asalahialassbahi-png/Rooftop/renders/step_7.png

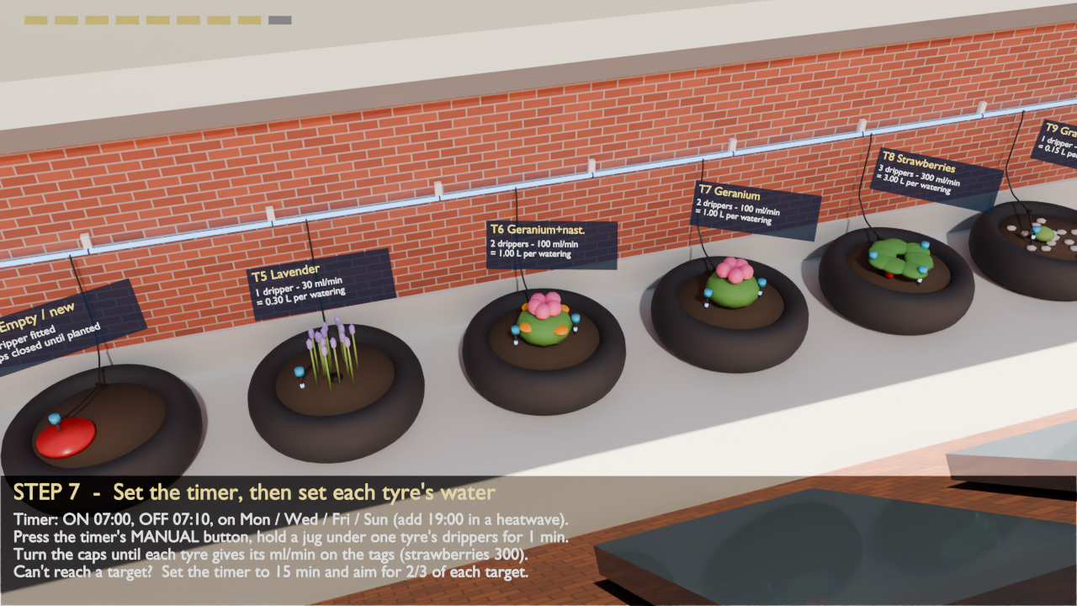
renders/step_7.png
