asalahialassbahi-png/Rooftop/renders/step_5.png

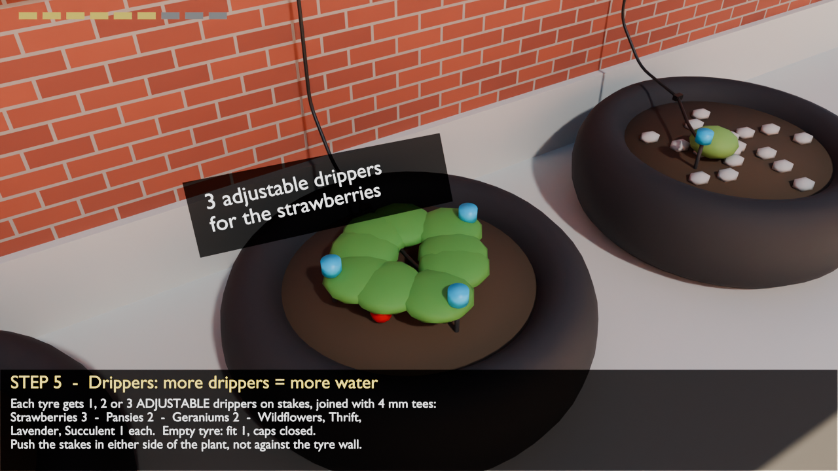
renders/step_5.png
