asalahialassbahi-png/Rooftop/(list of files, cad)

Other CAD files:
blender/irrigation_guide.blend
