asalahialassbahi-png/Rooftop/renders/step_0.png

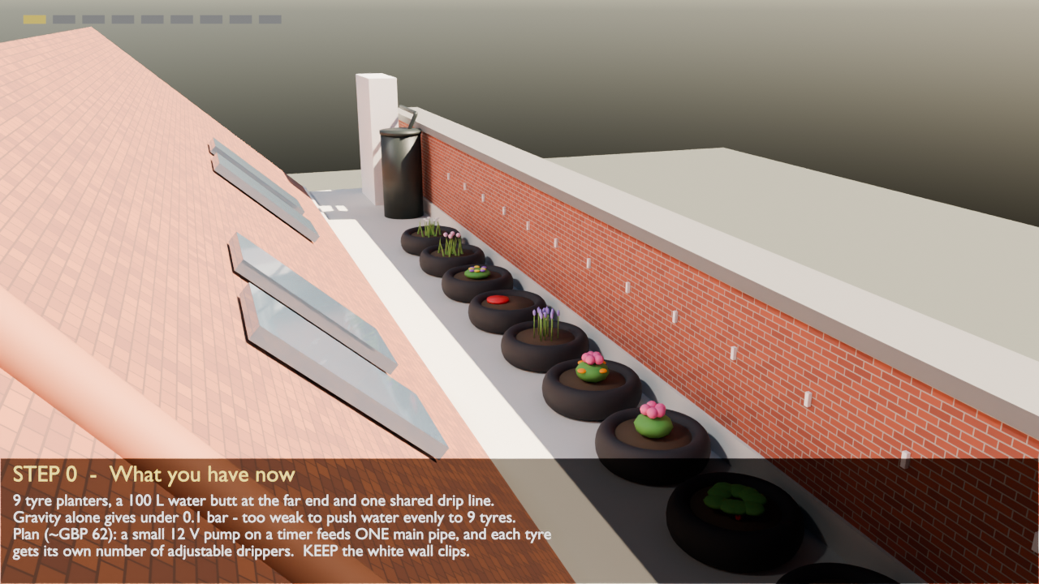
renders/step_0.png
