asalahialassbahi-png/Rooftop/renders/step_1.png

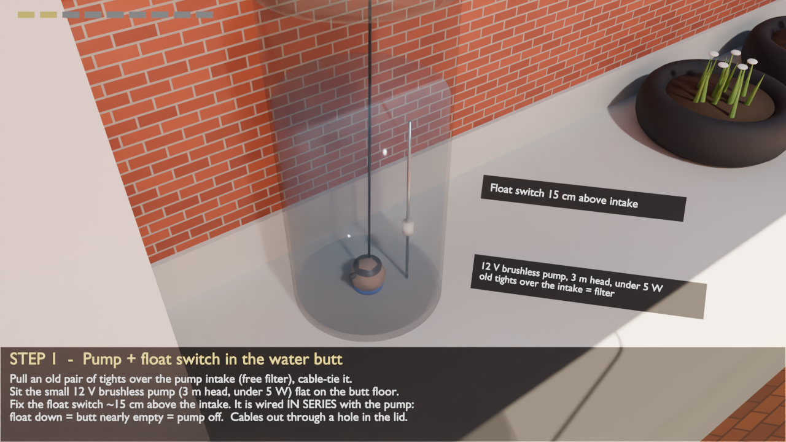
renders/step_1.png
