asalahialassbahi-png/Rooftop/renders/step_2.png

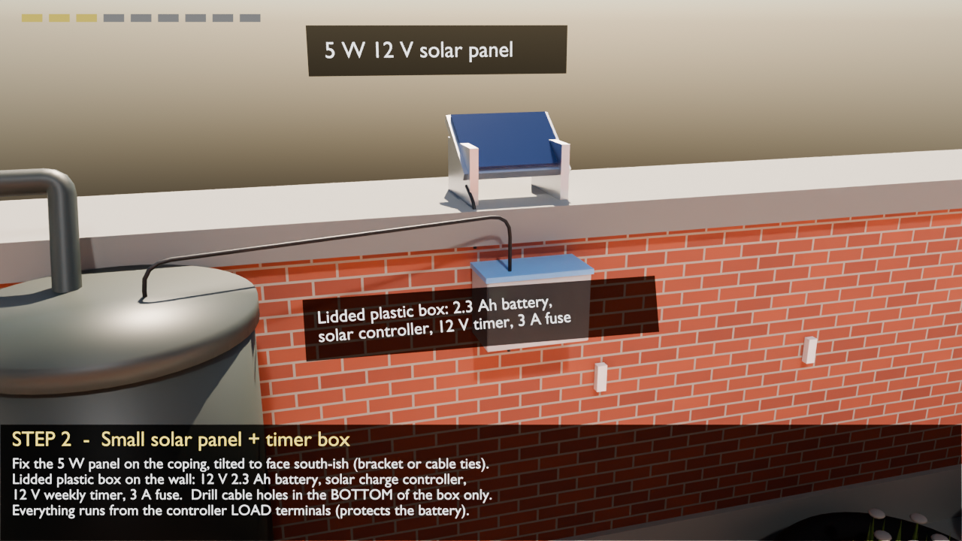
renders/step_2.png
