asalahialassbahi-png/Rooftop/renders/step_3.png

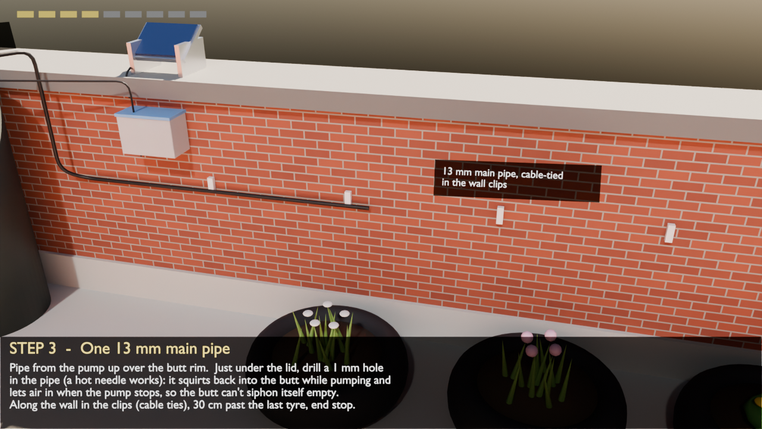
renders/step_3.png
