asalahialassbahi-png/Rooftop/renders/step_4.png

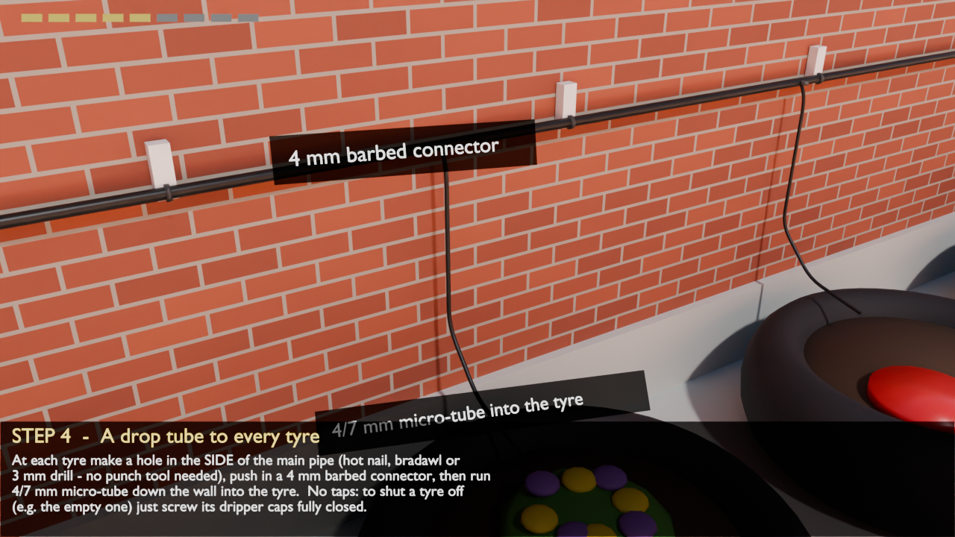
renders/step_4.png
