asalahialassbahi-png/Rooftop/renders/step_6.png

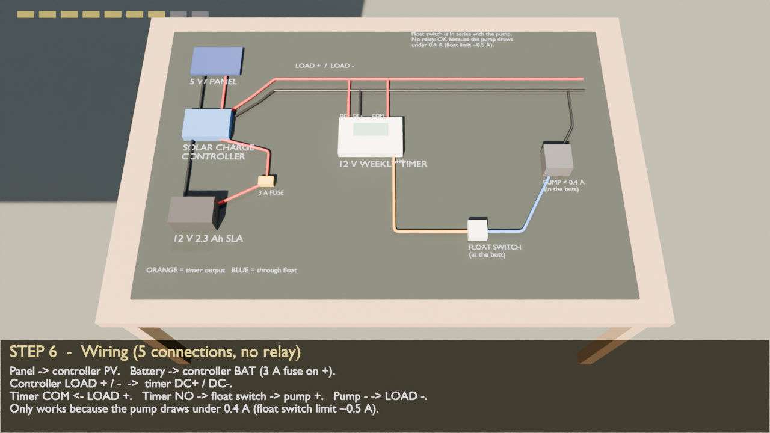
renders/step_6.png
