asalahialassbahi-png/Rooftop/renders/step_8.png

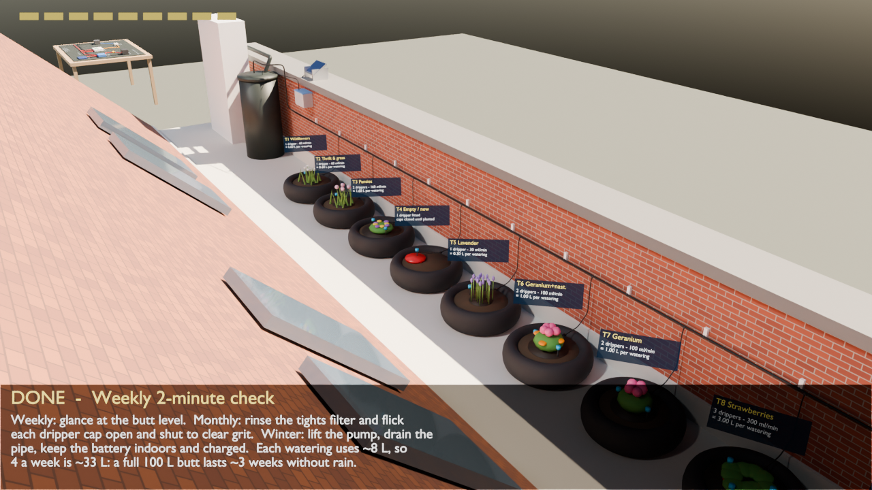
renders/step_8.png
