asalahialassbahi-png/Rooftop/(commit log)

2026-10-01 Add per-plant rooftop irrigation design: Blender step-by-step guide, ESP32 firmware, parts list
    Claude-Session: https://claude.ai/code/session_01FPgkAD5ey2pYwXbV5nmrNu
    [irrigation_guide.blend]
2026-10-01 Switch to a budget pumped drip design with per-tyre adjustable drippers
    One 12 V pump on a timer feeds a single 13 mm main pipe; each tyre's
    water is set by its number of adjustable drippers (jug-calibrated).
    Adds anti-siphon bleed, float-switch dry-run cut-off and solar power.
    The per-plant-schedule ESP32 design moves to upgrade-per-plant/.
    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
    [irrigation_guide.blend]
2026-10-02 Cut the build to ~GBP 62 for a college budget
    Smaller <5 W pump switched straight through the float switch (no relay),
    2.3 Ah battery + 5 W panel, plastic box, tights as the intake filter,
    1 mm anti-siphon hole instead of a tee, dripper caps instead of taps.
    Same per-plant amount control via dripper count and jug calibration.
    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
    [irrigation_guide.blend]
